mitali72/EDL-POF-Link/images/rx_output_1.jpeg

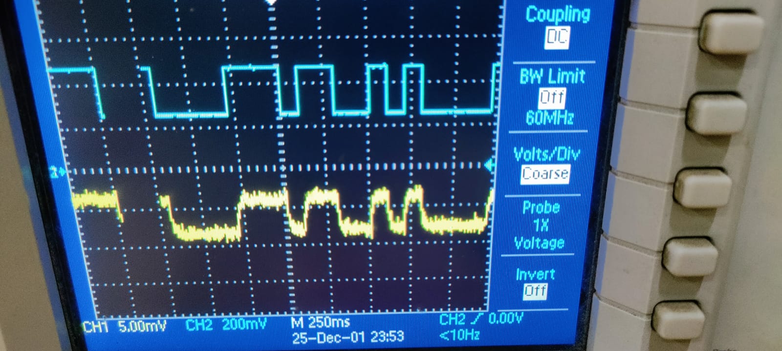
images/rx_output_1.jpeg
