mitali72/EDL-POF-Link/images/tx_output_1.jpeg

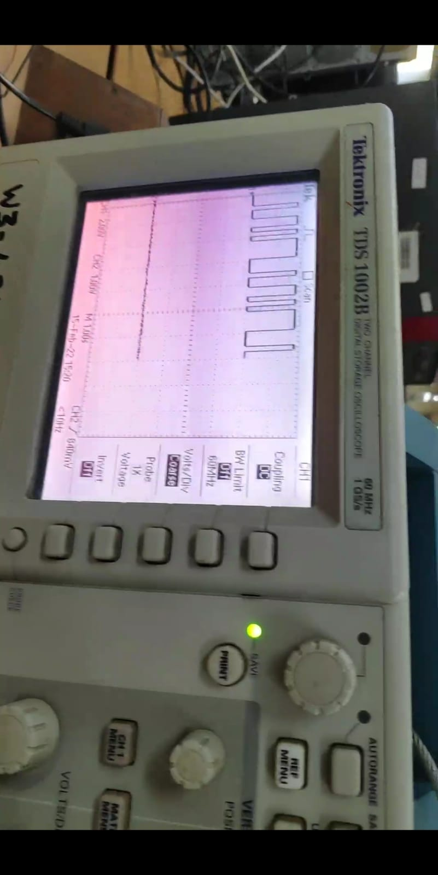
images/tx_output_1.jpeg
