mitali72/EDL-POF-Link/TUE-JJ-7-1_EDL_Final_PPT.pptx

## Low Cost 10 Mbps POF Link for Digital Transmission

Siddhi Bagul, Mitali Meratwal, Sheel Shah
(TUE-JJ-7-1)

## Block Diagram

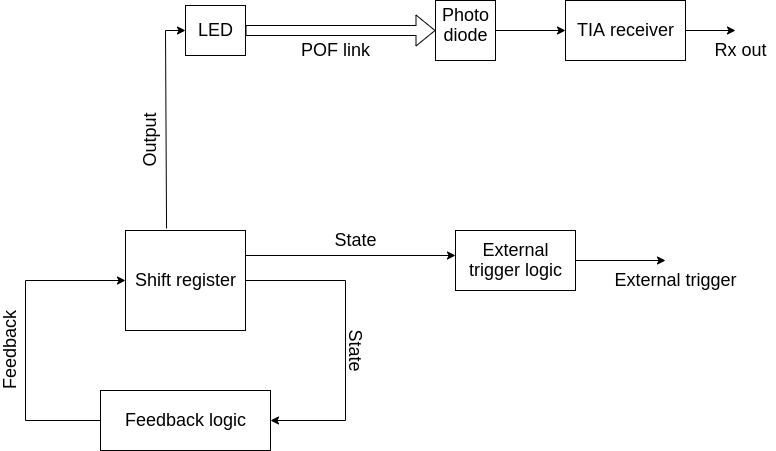
[picture p3: figure]

## DEMO Video

## LMH6629 VS. TL082

LMH6629 | TL082
Bandwidth 900 MHz (3dB) | Bandwidth 4 MHz (GBP)
Slew rate 1600 V/ us | Slew rate 13V/us
Noise Voltage 0.69 nV/√Hz | Noise Voltage 25 nV/√Hz

LMH6629: LMH6629 (https://www.ti.com/lit/ds/snosb18g/snosb18g.pdf?ts=1649741074371)
TL082: TL082 (https://www.ti.com/lit/ds/symlink/tl082-n.pdf?ts=1649740972470)

## Photodiode (SFH203P)

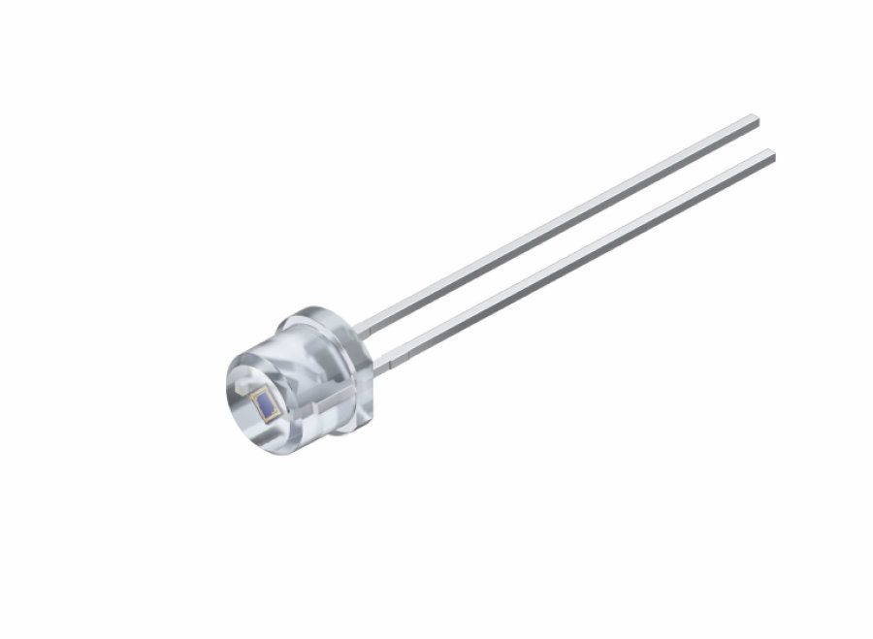
[picture p4: figure]

Image Source: https://www.osram.com/ecat/Radial%20T1%203-4%20SFH%20203%20P/com/en/class_pim_web_catalog_103489/prd_pim_device_2219552/

- Photocurrent ≥ 5uA
- Switching time 5 ns (Typ.)

## APPENDIX - I

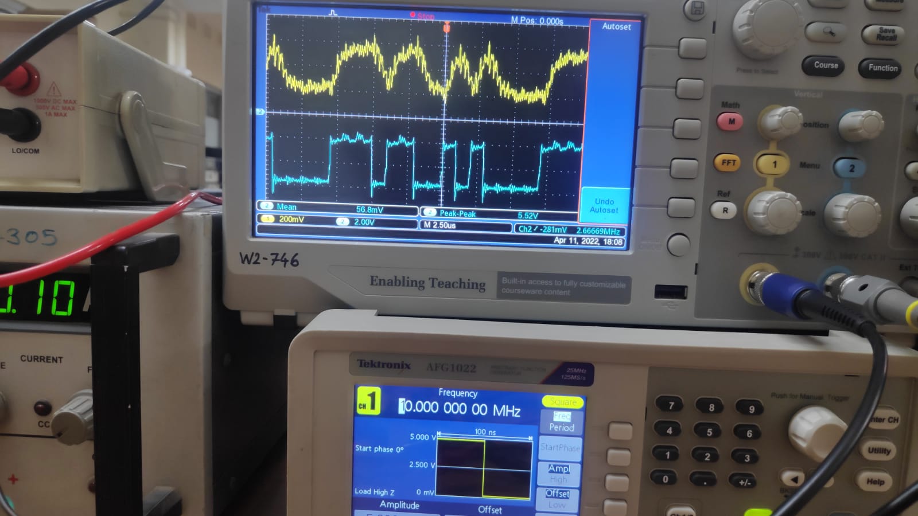
[picture p5: figure]

## APPENDIX - II

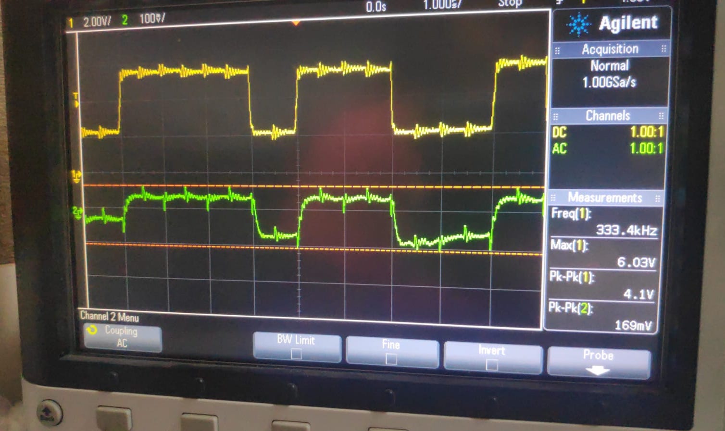
[picture p6: figure]

High speed comparator - LM361 (https://www.ti.com/lit/ds/symlink/lm361.pdf?ts=1649744501132)
Shift register - 74S195N (https://www.ti.com/lit/ds/symlink/sn74ls194a.pdf?ts=1649744611707)
