mitali72/EDL-POF-Link/images/breadboard_implementations_1.jpeg

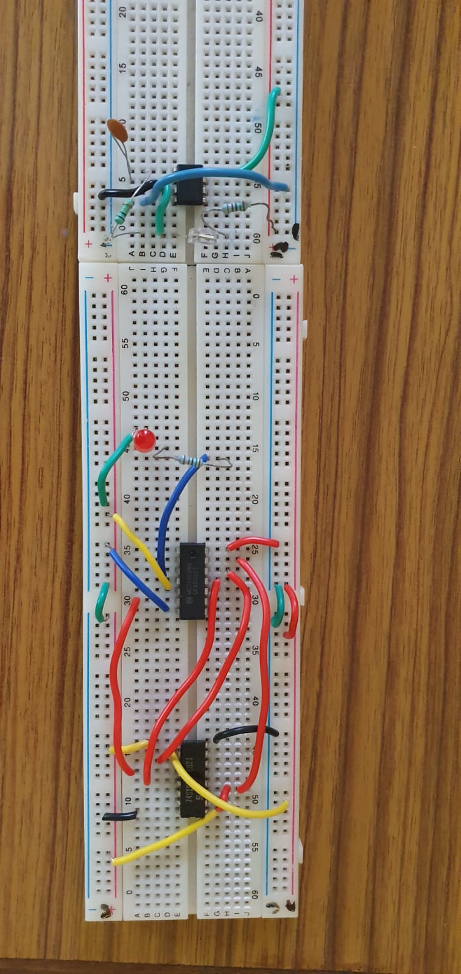
images/breadboard_implementations_1.jpeg
