mitali72/EDL-POF-Link/images/tx_ckt2.png

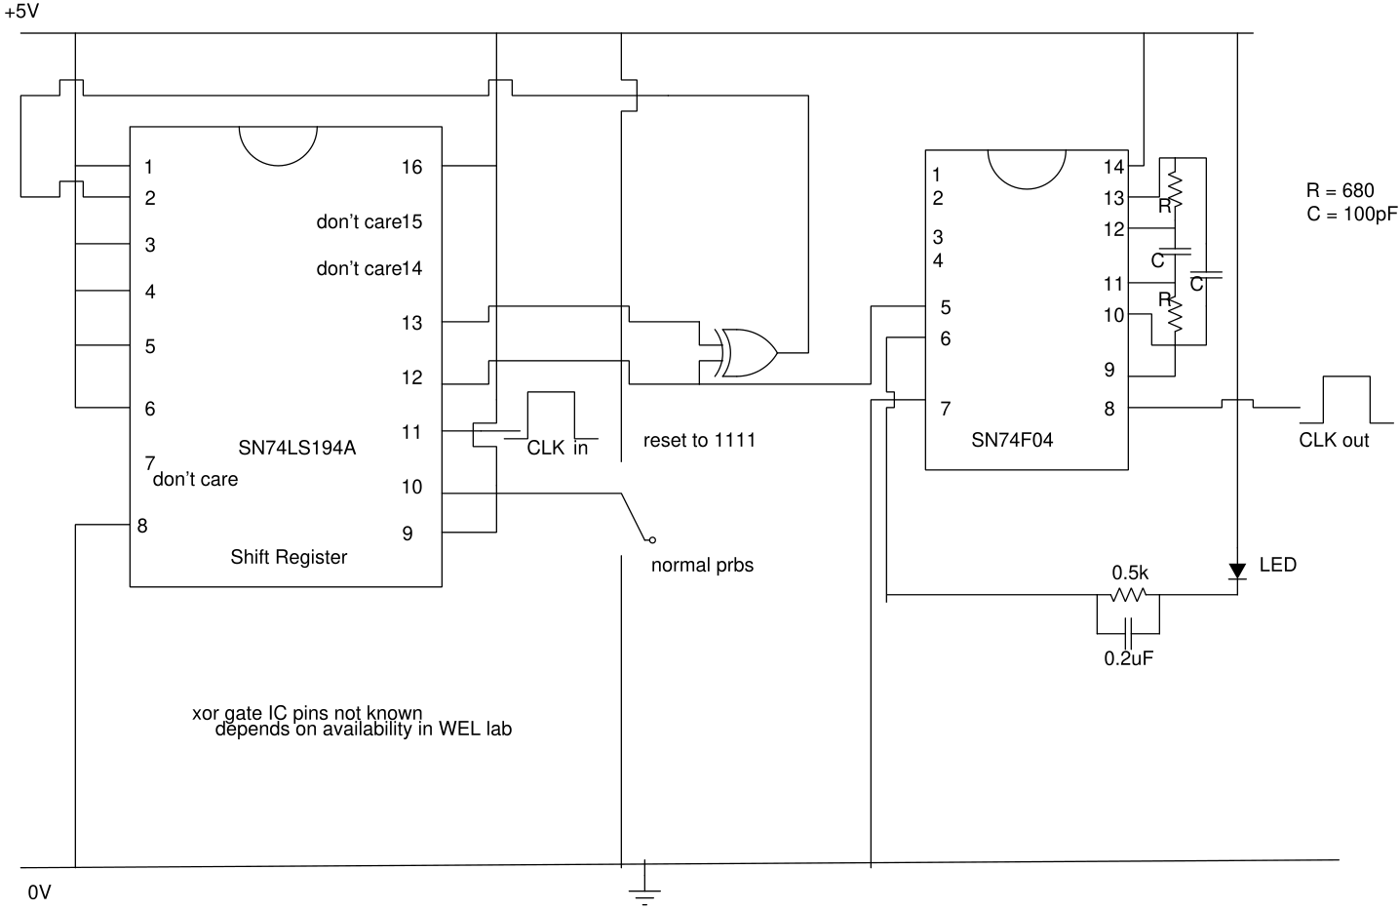
images/tx_ckt2.png
