mitali72/EDL-POF-Link/images/tx_ckt.png

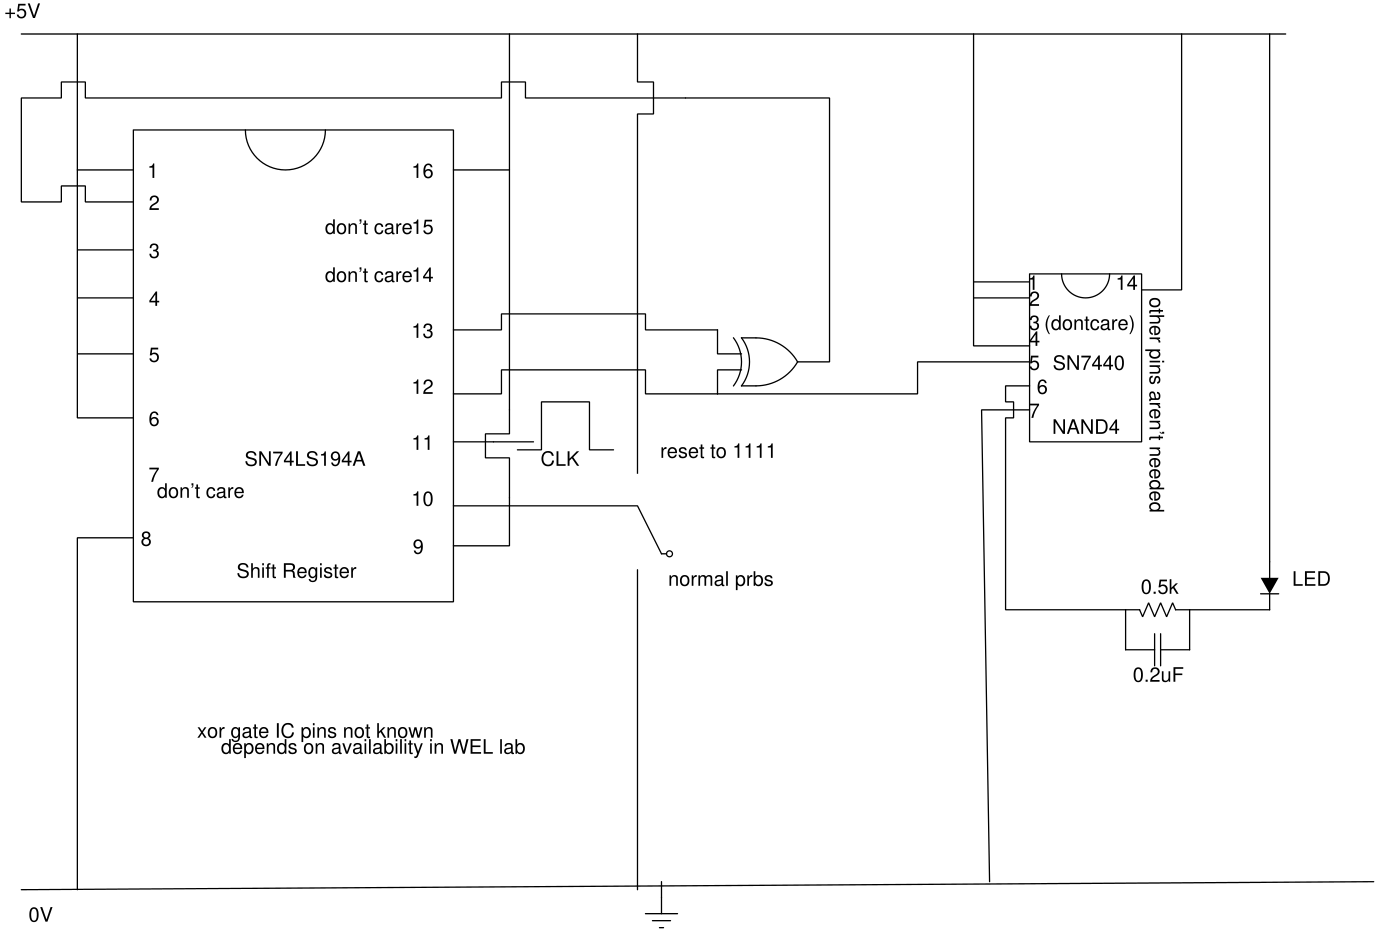
images/tx_ckt.png
