mitali72/EDL-POF-Link/edl_1/Tx_ckt_1.brd

## EAGLE design edl_1/Tx_ckt_1.brd (2022-10-04)

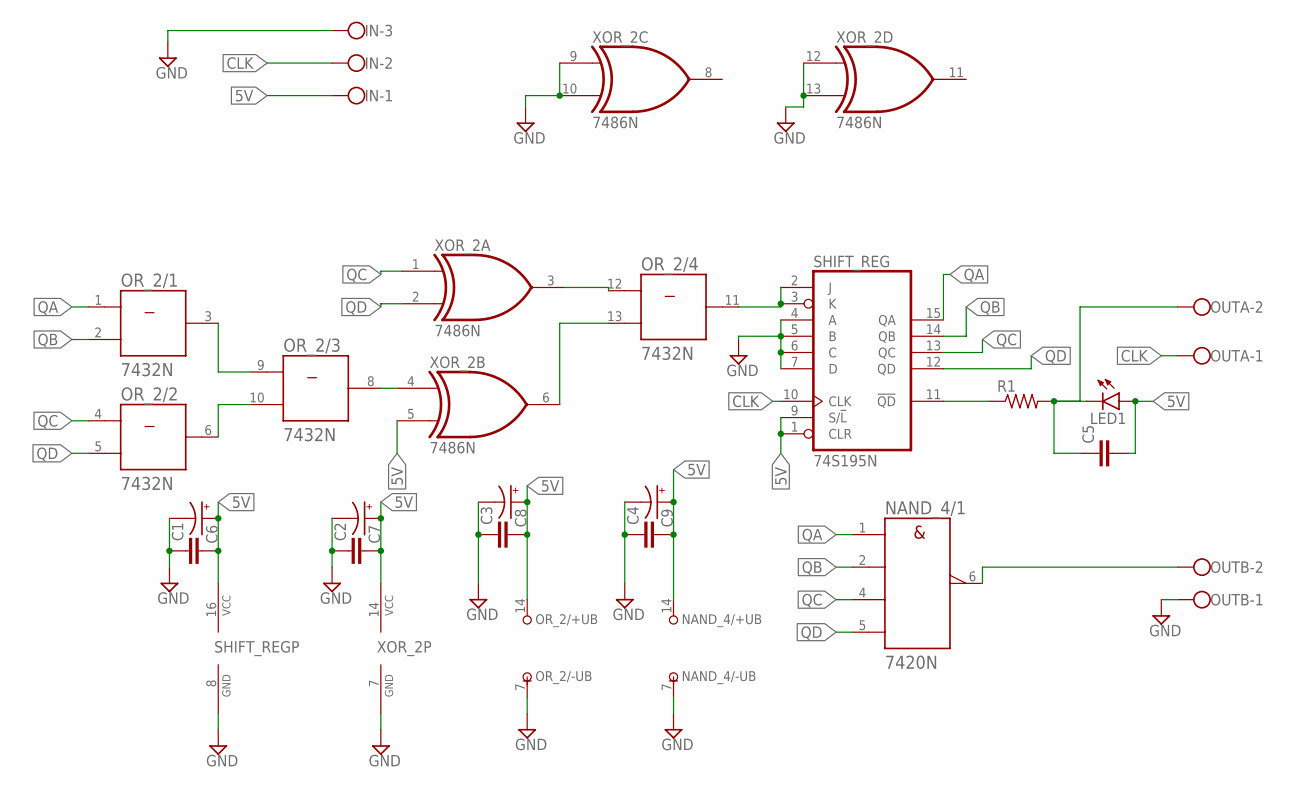
[picture p27: schematic Tx_ckt_1.sch]

Parts:
C1, C2, C3, C4, C5: C-EU050-025X075; C050-025X075
C6, C7, C8, C9: CPOL-USE2.5-7; E2,5-7
IN: W237-103
LED1: LED5MM
NAND_4: 7420N; DIL14
OR_2: 7432N; DIL14
OUTA: W237-102
OUTB: W237-102
R1: R-US_0207/10; 0207/10
SHIFT_REG: 74S195N; DIL16
XOR_2: 7486N; DIL14

Connections:
5V: C1.2, C2.2, C3.2, C4.2, C5.2, C6.+, C7.+, C8.+, C9.+, IN.1, LED1.A, NAND_4.14 (+UB), OR_2.14 (+UB), SHIFT_REG.1 (CLR), SHIFT_REG.9 (S/!L), SHIFT_REG.16 (VCC), XOR_2.5 (I1), XOR_2.14 (VCC)
CLK: IN.2, OUTA.1, SHIFT_REG.10 (CLK)
GND: C1.1, C2.1, C3.1, C4.1, C6.-, C7.-, C8.-, C9.-, IN.3, NAND_4.7 (-UB), OR_2.7 (-UB), OUTB.1, SHIFT_REG.4 (A), SHIFT_REG.5 (B), SHIFT_REG.6 (C), SHIFT_REG.7 (D), SHIFT_REG.8 (GND), XOR_2.7 (GND), XOR_2.9 (I0), XOR_2.10 (I1), XOR_2.12 (I0), XOR_2.13 (I1)
unnamed: OR_2.11 (Y), SHIFT_REG.2 (J), SHIFT_REG.3 (K)
unnamed: OR_2.12 (A), XOR_2.3 (O)
unnamed: OR_2.13 (B), XOR_2.6 (O)
unnamed: R1.1, SHIFT_REG.11 (!QD)
unnamed: C5.1, LED1.K (C), OUTA.2, R1.2
unnamed: NAND_4.6 (Y), OUTB.2
unnamed: OR_2.3 (Y), OR_2.9 (A)
unnamed: OR_2.6 (Y), OR_2.10 (B)
unnamed: OR_2.8 (Y), XOR_2.4 (I0)
QA: NAND_4.1 (A), OR_2.1 (A), SHIFT_REG.15 (QA)
QB: NAND_4.2 (B), OR_2.2 (B), SHIFT_REG.14 (QB)
QC: NAND_4.4 (C), OR_2.4 (A), SHIFT_REG.13 (QC), XOR_2.1 (I0)
QD: NAND_4.5 (D), OR_2.5 (B), SHIFT_REG.12 (QD), XOR_2.2 (I1)

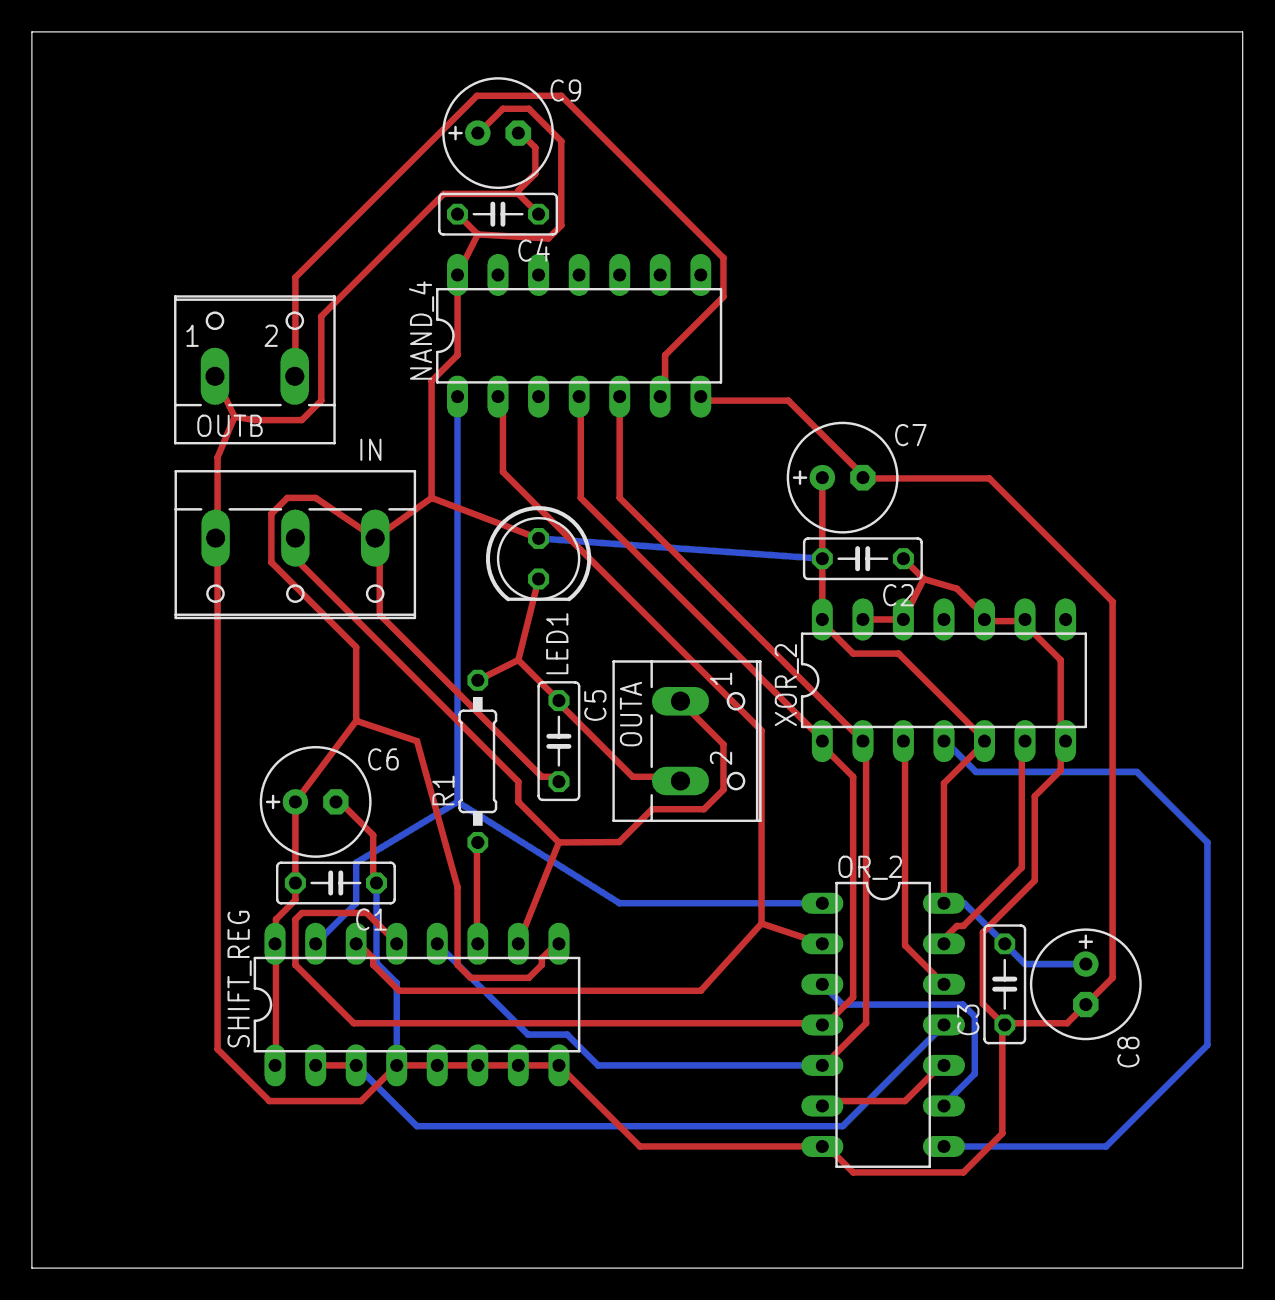
[picture p28: board Tx_ckt_1.brd from above]

Board: 2 copper layers, 75.9 x 77.5 mm, 18 parts (0 on the bottom side), 16 nets.
