mitali72/EDL-POF-Link/edl_1/Rx_ckt_1.brd

## EAGLE design edl_1/Rx_ckt_1.brd (2022-10-04)

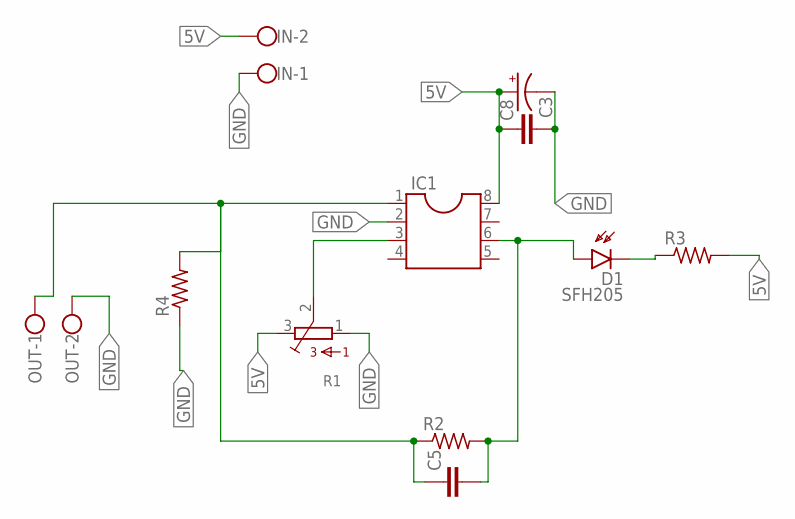
[picture p29: schematic Rx_ckt_1.sch]

Parts:
C3, C5: C-EU050-025X075; C050-025X075
C8: CPOL-USE2.5-7; E2,5-7
D1: SFH205
IC1: DIL8; DIL08
IN: W237-102
OUT: W237-102
R1: 3386-F; 3386F
R2, R3, R4: R-US_0207/10; 0207/10

Connections:
5V: C3.2, C8.+, IC1.8, IN.2, R1.3, R3.2
GND: C3.1, C8.-, IC1.2, IN.1, OUT.2, R1.1, R4.1
unnamed: IC1.3, R1.2
unnamed: C5.1, IC1.1, OUT.1, R2.1, R4.2
unnamed: C5.2, D1.A, IC1.6, R2.2
unnamed: D1.K (C), R3.1

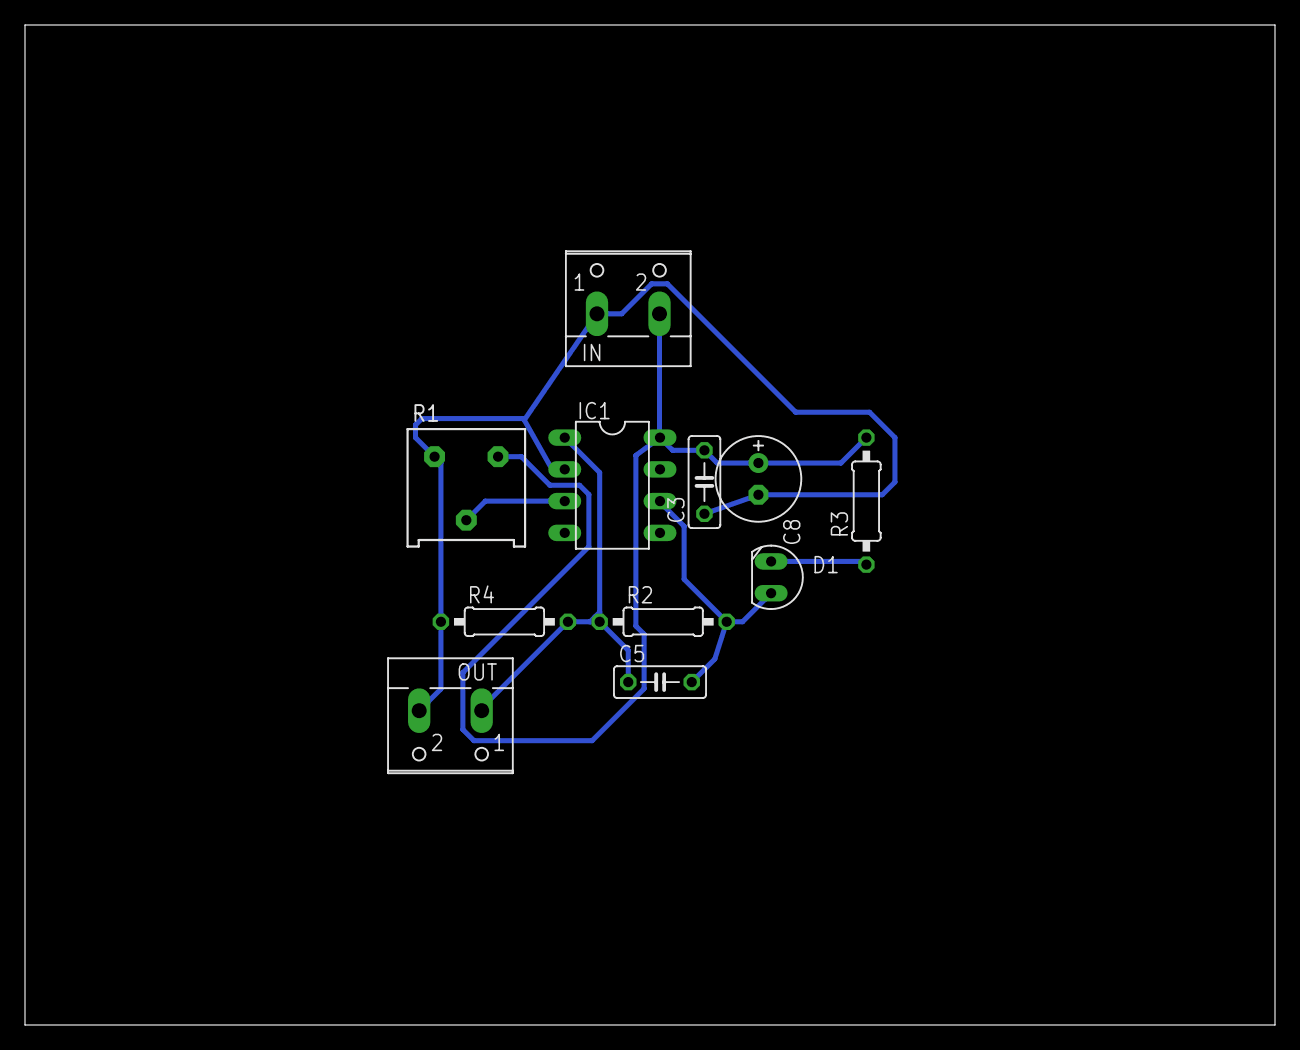
[picture p30: board Rx_ckt_1.brd from above]

Board: 2 copper layers, 100.0 x 80.0 mm, 11 parts (0 on the bottom side), 6 nets.
